roger225/DapLink_STM32F103CBT6/DapLink_STM32F103CBT6.step

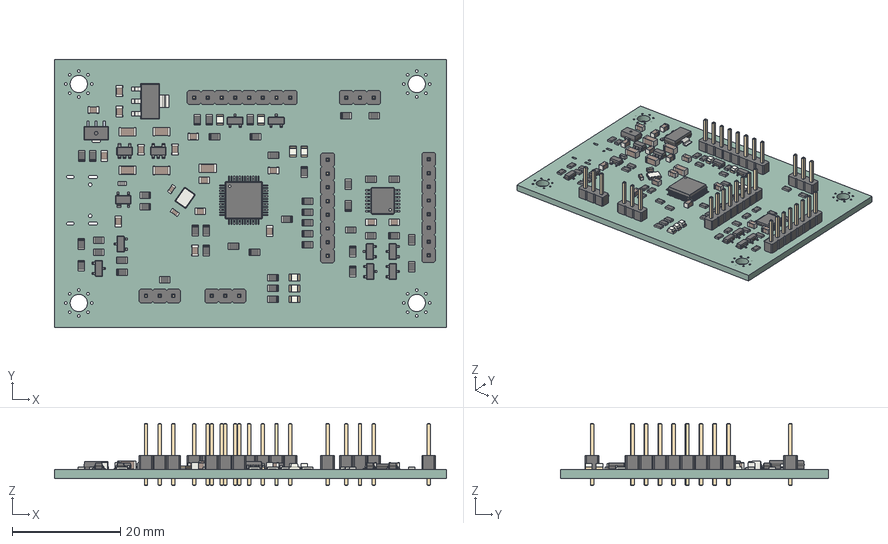
[picture p1: CAD file, 2024-07-27]
DapLink_STM32F103CBT6.step
72.5 x 49.5 x 11.5 mm
R_0805_2012Metric x 45
PinHeader_1x08_P254mm_Vertical x 3
C_0805_2012Metric x 15
TSSOP_14_44x5mm_P065mm
SOT_23_5 x 2
C_1206_3216Metric x 5
PinHeader_1x03_P254mm_Vertical x 3
LED_0805_2012Metric x 7
SOT_23 x 8
CQ assembly
SOT_143
C_0603_1608Metric x 2
L_0603_1608Metric
Crystal_SMD_3225-4Pin_3.2x2.5mm
LQFP_48_7x7mm_P05mm
SOT_223
DapLink_STM32F103CBT6_PCB
