roger225/DapLink_STM32F103CBT6/RefDesign/Interface Schematics/DAPlink_STM32F103-v1.0.0_20200618.pdf

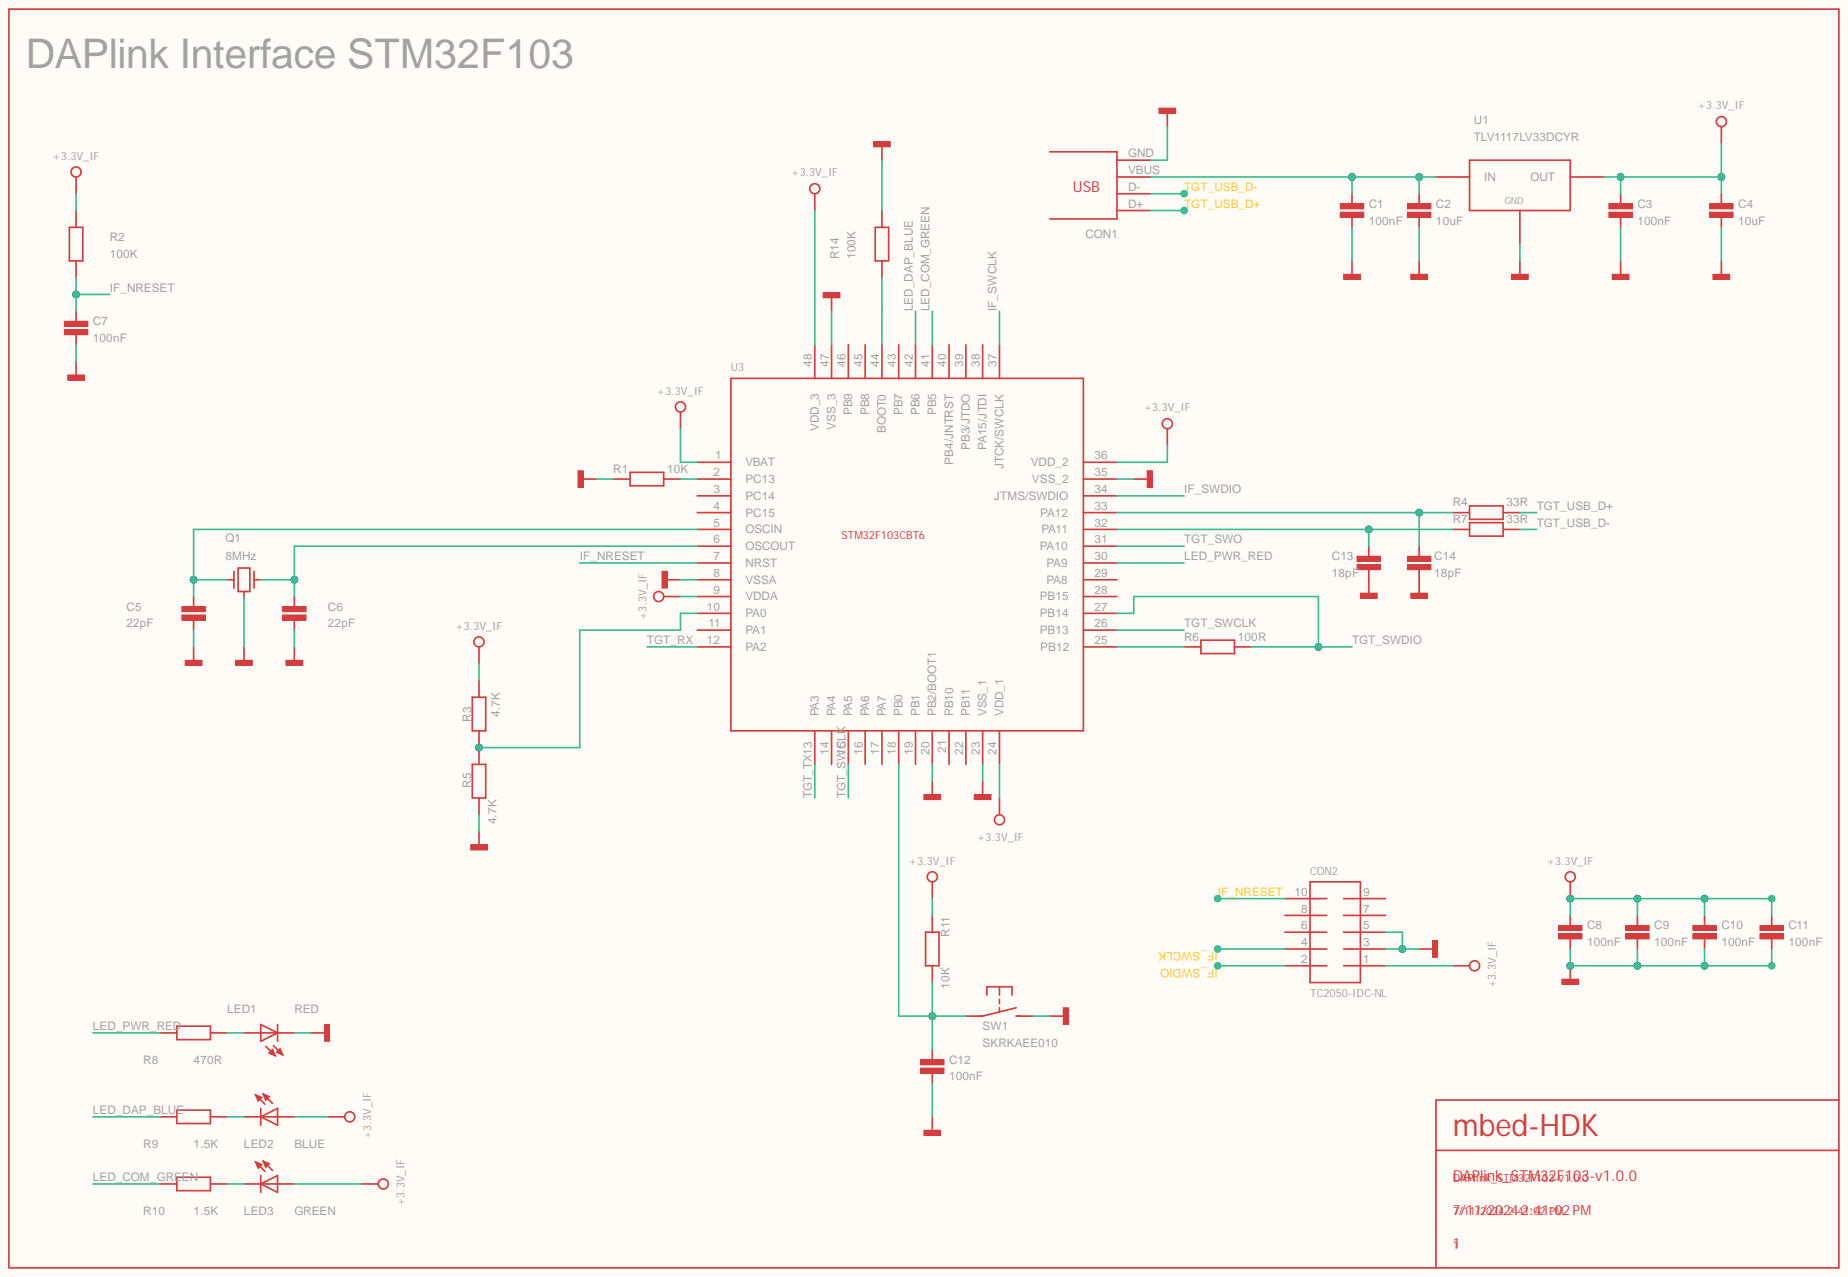
[picture p3: page 1]
