roger225/DapLink_STM32F103CBT6/DapLink_STM32F103CBT6.kicad_pcb

## KiCad design DapLink_STM32F103CBT6.kicad_pcb (2024-08-18)

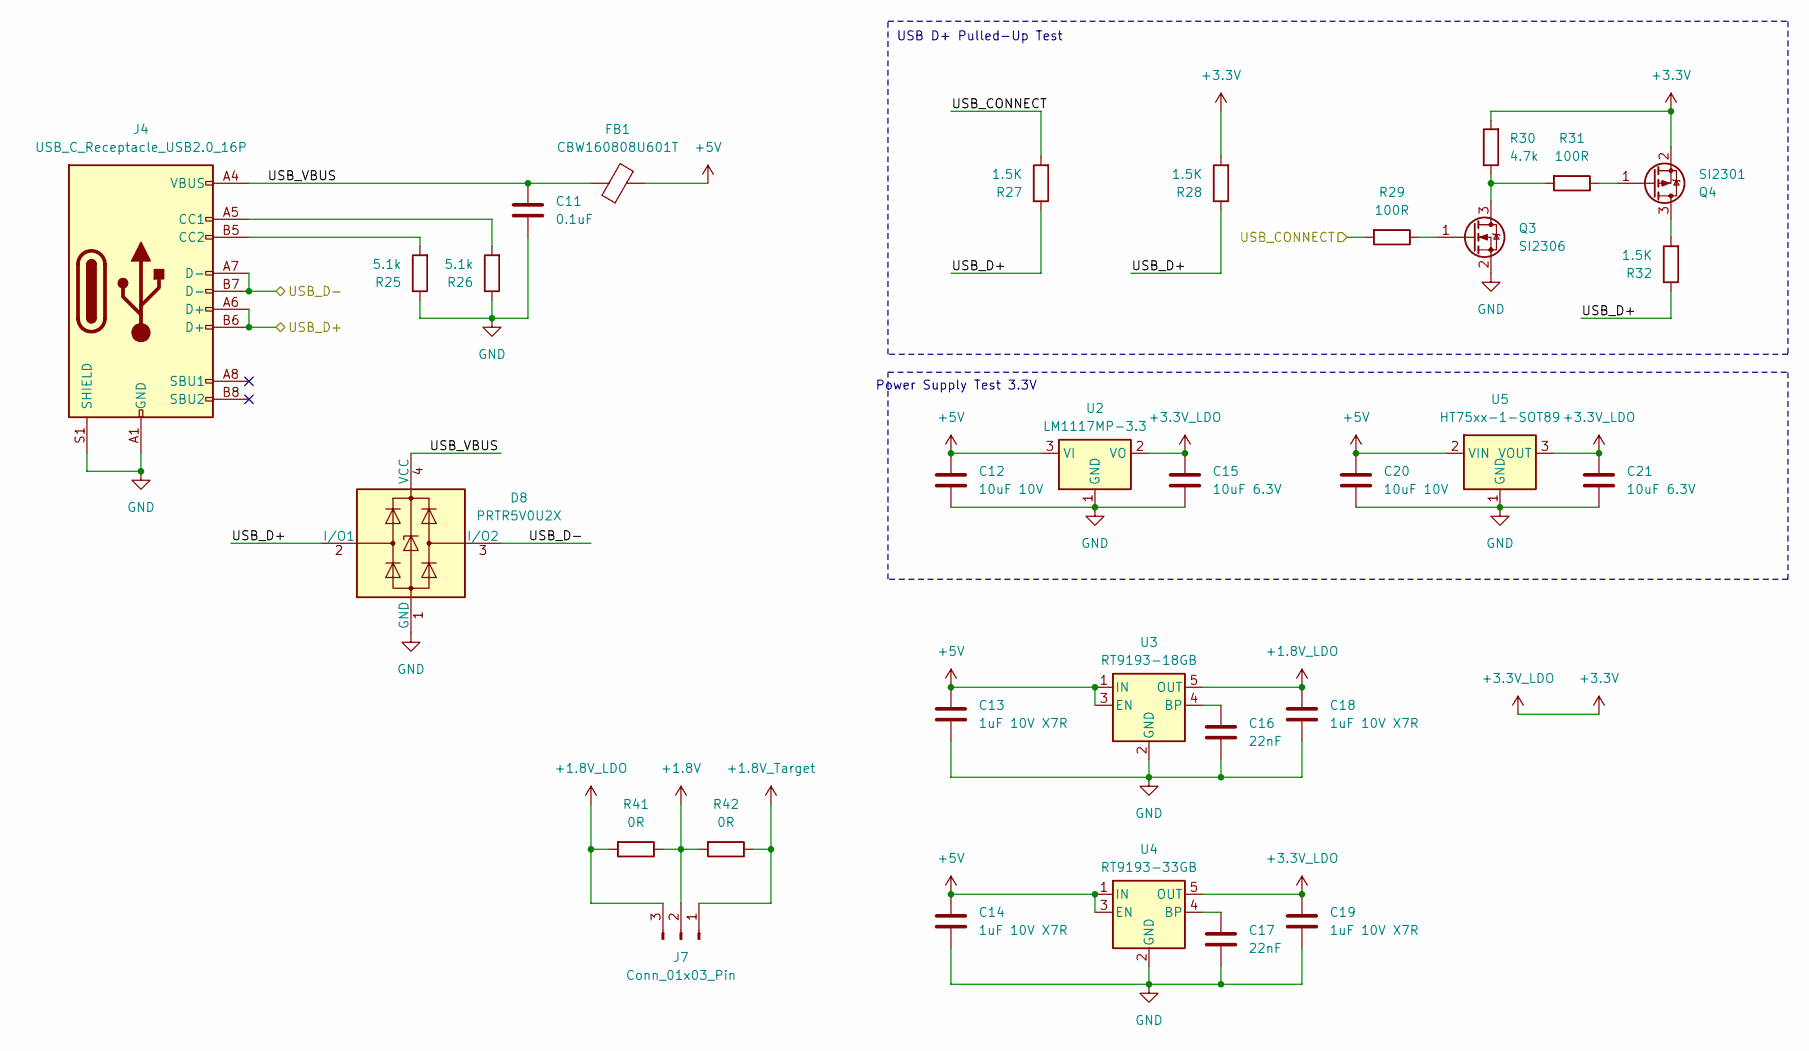
[picture p4: schematic UsbAndPower.kicad_sch, DapLink_STM32F103CBT6]

Parts:
C11: 0.1uF; C_0805_2012Metric
C12, C20: 10uF 10V; C_0805_2012Metric
C13, C14, C18, C19: 1uF 10V X7R; C_1206_3216Metric
C15, C21: 10uF 6.3V; C_0805_2012Metric
C16, C17: 22nF; C_0805_2012Metric
D8: PRTR5V0U2X; SOT-143
FB1: CBW160808U601T; L_0603_1608Metric
J4: USB_C_Receptacle_USB2.0_16P; USB_C_Receptacle_G-Switch_GT-USB-7010ASV
J7: Conn_01x03_Pin; PinHeader_1x03_P2.54mm_Vertical
Q3: SI2306; SOT-23
Q4: SI2301; SOT-23
R25, R26: 5.1k; R_0805_2012Metric
R27, R28, R32: 1.5K; R_0805_2012Metric
R29, R31: 100R; R_0805_2012Metric
R30: 4.7k; R_0805_2012Metric
R41, R42: 0R; R_0805_2012Metric
U2: LM1117MP-3.3; SOT-223-3_TabPin2
U3: RT9193-18GB; SOT-23-5
U4: RT9193-33GB; SOT-23-5
U5: HT75xx-1-SOT89; SOT-89-3

Connections:
+1.8V: J7.2, R41.1, R42.2; also elsewhere on the board
+1.8V_LDO: C18.1, J7.3, R41.2, U3.5 (OUT)
+1.8V_Target: J7.1, R42.1; also elsewhere on the board
+3.3V: C15.1, C19.1, C21.1, Q4.2 (S), R28.2, R30.2, U2.2 (VO), U4.5 (OUT), U5.3 (VOUT); also elsewhere on the board
+5V: C12.1, C13.1, C14.1, C20.1, FB1.2, U2.3 (VI), U3.1 (IN), U3.3 (EN), U4.1 (IN), U4.3 (EN), U5.2 (VIN)
/UsbAndPower/USB_CONNECT: R27.2, R29.2; also elsewhere on the board
/UsbAndPower/USB_D+: D8.2 (I/O1), J4.A6 (D+), J4.B6 (D+), R27.1, R28.1, R32.1; also elsewhere on the board
/UsbAndPower/USB_D-: D8.3 (I/O2), J4.A7 (D-), J4.B7 (D-); also elsewhere on the board
/UsbAndPower/USB_VBUS: C11.1, D8.4 (VCC), FB1.1, J4.A4 (VBUS), J4.A9 (VBUS), J4.B4 (VBUS), J4.B9 (VBUS)
GND: C11.2, C12.2, C13.2, C14.2, C15.2, C16.2, C17.2, C18.2, C19.2, C20.2, C21.2, D8.1 (GND), J4.A1 (GND), J4.A12 (GND), J4.B1 (GND), J4.B12 (GND), J4.S1 (SHIELD), Q3.2 (S), R25.1, R26.1, U2.1 (GND), U3.2 (GND), U4.2 (GND), U5.1 (GND); also elsewhere on the board
unnamed: J4.A5 (CC1), R26.2
unnamed: J4.B5 (CC2), R25.2
unnamed: Q3.3 (D), R30.1, R31.2
unnamed: Q3.1 (G), R29.1
unnamed: Q4.3 (D), R32.2
unnamed: Q4.1 (G), R31.1
unnamed: C16.1, U3.4 (BP)
unnamed: C17.1, U4.4 (BP)

Notes on the sheet:
Power Supply Test 3.3V
USB D+ Pulled-Up Test

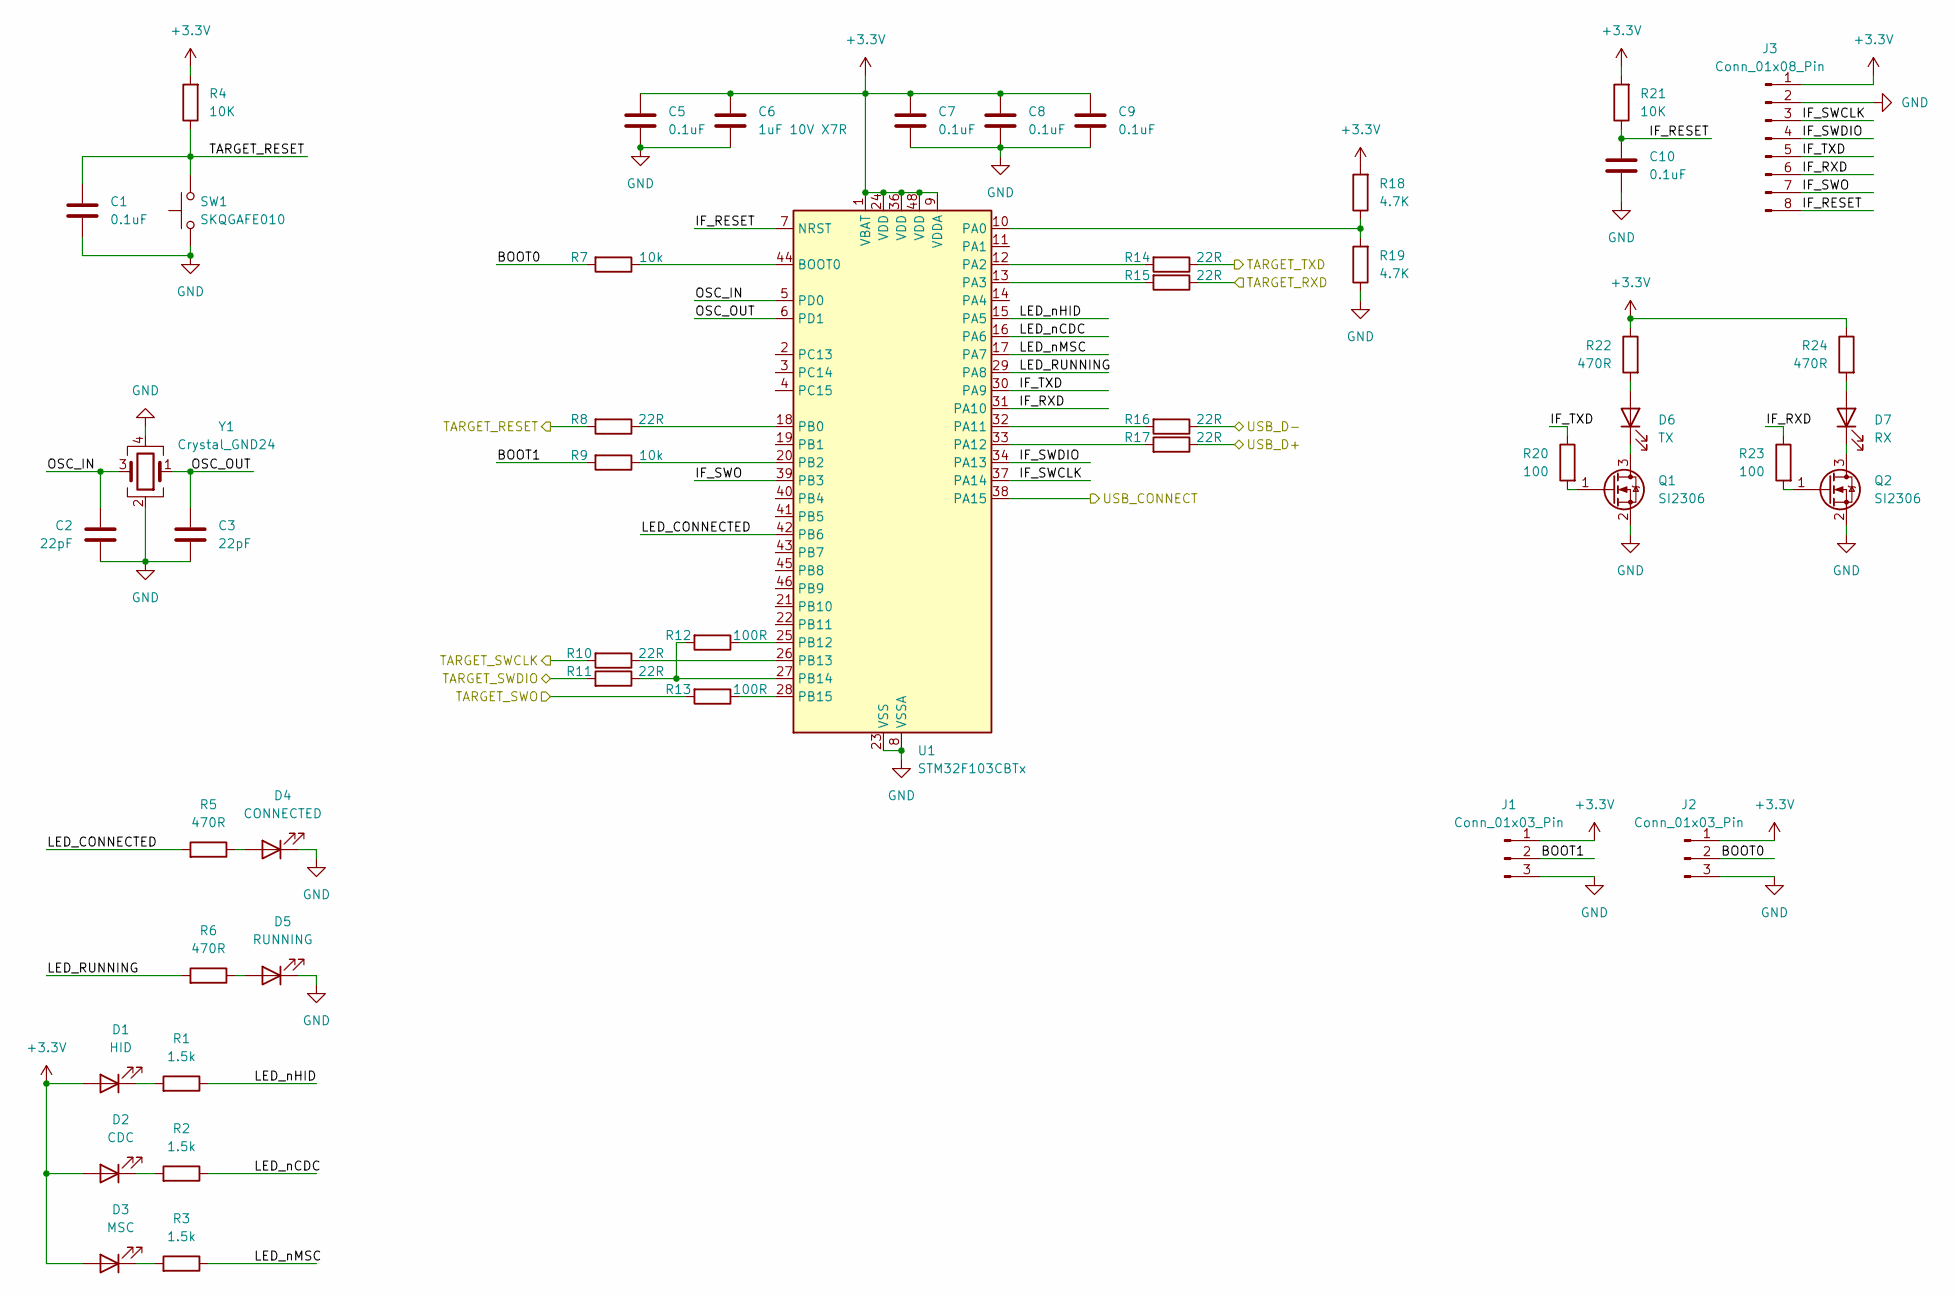
[picture p5: schematic Mcu.kicad_sch, DapLink_STM32F103CBT6]

Parts:
C1, C5, C7, C8, C9, C10: 0.1uF; C_0805_2012Metric
C2, C3: 22pF; C_0603_1608Metric
C6: 1uF 10V X7R; C_1206_3216Metric
D1: HID; LED_0805_2012Metric
D2: CDC; LED_0805_2012Metric
D3: MSC; LED_0805_2012Metric
D4: CONNECTED; LED_0805_2012Metric
D5: RUNNING; LED_0805_2012Metric
D6: TX; LED_0805_2012Metric
D7: RX; LED_0805_2012Metric
J1, J2: Conn_01x03_Pin; PinHeader_1x03_P2.54mm_Vertical
J3: Conn_01x08_Pin; PinHeader_1x08_P2.54mm_Vertical
Q1, Q2: SI2306; SOT-23
R1, R2, R3: 1.5k; R_0805_2012Metric
R4, R21: 10K; R_0805_2012Metric
R5, R6, R22, R24: 470R; R_0805_2012Metric
R7, R9: 10k; R_0805_2012Metric
R8, R10, R11, R14, R15, R16, R17: 22R; R_0805_2012Metric
R12, R13: 100R; R_0805_2012Metric
R18, R19: 4.7K; R_0805_2012Metric
R20, R23: 100; R_0805_2012Metric
SW1: SKQGAFE010; SW_SPST_SKQG_WithStem
U1: STM32F103CBTx; LQFP-48_7x7mm_P0.5mm
Y1: Crystal_GND24; Crystal_SMD_3225-4Pin_3.2x2.5mm

Connections:
+3.3V: C5.1, C6.1, C7.1, C8.1, C9.1, D1.2 (A), D2.2 (A), D3.2 (A), J1.1, J2.1, J3.1, R4.2, R18.2, R21.2, R22.1, R24.1, U1.1 (VBAT), U1.9 (VDDA), U1.24 (VDD), U1.36 (VDD), U1.48 (VDD); also elsewhere on the board
/DebugAndUart/TARGET_RESET: C1.1, R4.1, R8.2, SW1.2; also elsewhere on the board
/DebugAndUart/TARGET_RXD: R15.1; also elsewhere on the board
/DebugAndUart/TARGET_SWCLK: R10.2; also elsewhere on the board
/DebugAndUart/TARGET_SWDIO: R11.2; also elsewhere on the board
/DebugAndUart/TARGET_SWO: R13.2; also elsewhere on the board
/DebugAndUart/TARGET_TXD: R14.1; also elsewhere on the board
/Mcu/BOOT0: J2.2, R7.2
/Mcu/BOOT1: J1.2, R9.2
/Mcu/IF_RESET: C10.1, J3.8, R21.1, U1.7 (NRST)
/Mcu/IF_RXD: J3.6, R23.1, U1.31 (PA10)
/Mcu/IF_SWCLK: J3.3, U1.37 (PA14)
/Mcu/IF_SWDIO: J3.4, U1.34 (PA13)
/Mcu/IF_SWO: J3.7, U1.39 (PB3)
/Mcu/IF_TXD: J3.5, R20.1, U1.30 (PA9)
/Mcu/LED_CONNECTED: R5.2, U1.42 (PB6)
/Mcu/LED_RUNNING: R6.2, U1.29 (PA8)
/Mcu/LED_nCDC: R2.1, U1.16 (PA6)
/Mcu/LED_nHID: R1.1, U1.15 (PA5)
/Mcu/LED_nMSC: R3.1, U1.17 (PA7)
/Mcu/OSC_IN: C2.2, U1.5 (PD0), Y1.3
/Mcu/OSC_OUT: C3.1, U1.6 (PD1), Y1.1
/UsbAndPower/USB_CONNECT: U1.38 (PA15); also elsewhere on the board
/UsbAndPower/USB_D+: R17.1; also elsewhere on the board
/UsbAndPower/USB_D-: R16.1; also elsewhere on the board
GND: C1.2, C2.1, C3.2, C5.2, C6.2, C7.2, C8.2, C9.2, C10.2, D4.1 (K), D5.1 (K), J1.3, J2.3, J3.2, Q1.2 (S), Q2.2 (S), R19.1, SW1.1, U1.8 (VSSA), U1.23 (VSS), U1.35 (VSS), U1.47 (VSS), Y1.2, Y1.4; also elsewhere on the board
unnamed: D1.1 (K), R1.2
unnamed: D2.1 (K), R2.2
unnamed: D3.1 (K), R3.2
unnamed: D4.2 (A), R5.1
unnamed: D5.2 (A), R6.1
unnamed: D6.2 (A), R22.2
unnamed: D6.1 (K), Q1.3 (D)
unnamed: D7.2 (A), R24.2
unnamed: D7.1 (K), Q2.3 (D)
unnamed: Q1.1 (G), R20.2
unnamed: Q2.1 (G), R23.2
unnamed: R7.1, U1.44 (BOOT0)
unnamed: R18.1, R19.2, U1.10 (PA0)
unnamed: R14.2, U1.12 (PA2)
unnamed: R15.2, U1.13 (PA3)
unnamed: R16.2, U1.32 (PA11)
unnamed: R17.2, U1.33 (PA12)
unnamed: R8.1, U1.18 (PB0)
unnamed: R9.1, U1.20 (PB2)
unnamed: R12.1, U1.25 (PB12)
unnamed: R10.1, U1.26 (PB13)
unnamed: R11.1, R12.2, U1.27 (PB14)
unnamed: R13.1, U1.28 (PB15)

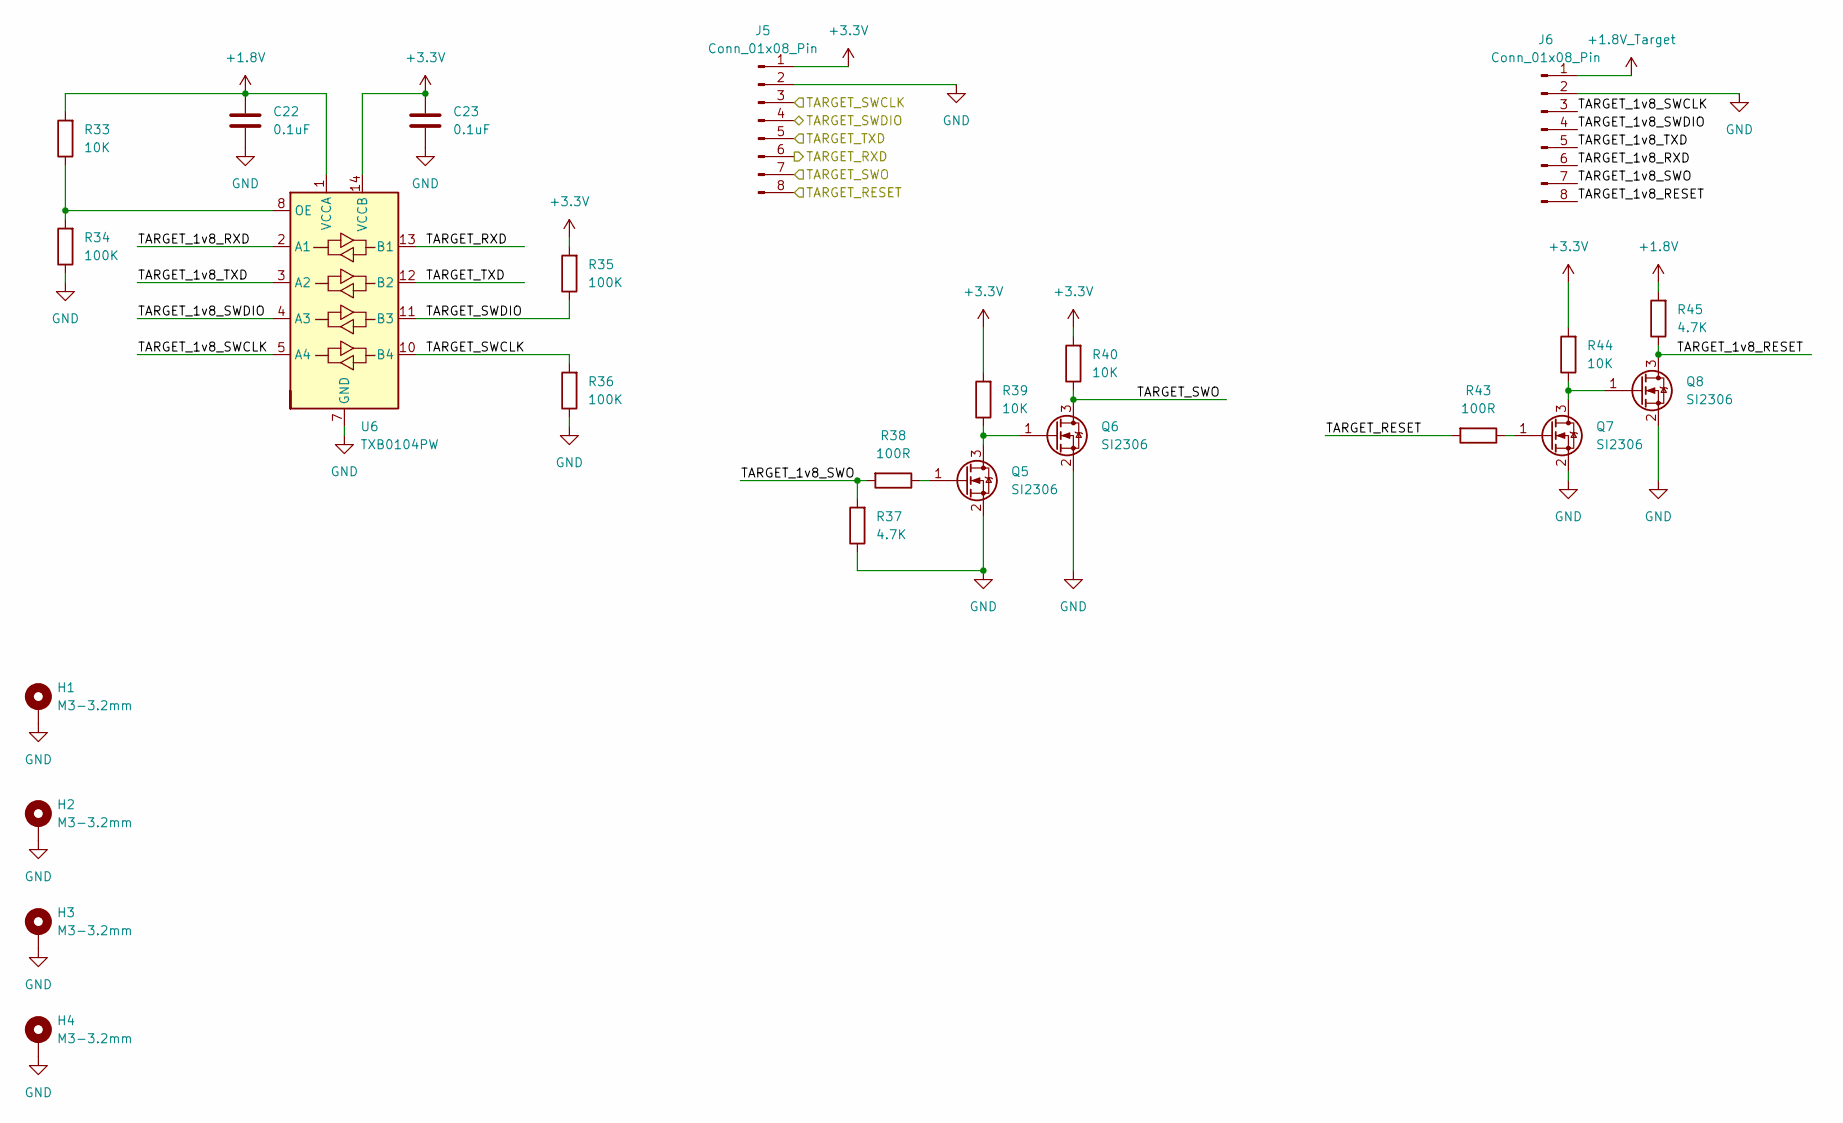
[picture p6: schematic DebugAndUart.kicad_sch, DapLink_STM32F103CBT6]

Parts:
C22, C23: 0.1uF; C_0805_2012Metric
H1, H2, H3, H4: M3-3.2mm; MountingHole_3.2mm_M3_Pad_Via
J5, J6: Conn_01x08_Pin; PinHeader_1x08_P2.54mm_Vertical
Q5, Q6, Q7, Q8: SI2306; SOT-23
R33, R39, R40, R44: 10K; R_0805_2012Metric
R34, R35, R36: 100K; R_0805_2012Metric
R37, R45: 4.7K; R_0805_2012Metric
R38, R43: 100R; R_0805_2012Metric
U6: TXB0104PW; TSSOP-14_4.4x5mm_P0.65mm

Connections:
+1.8V: C22.1, R33.2, R45.2, U6.1 (VCCA); also elsewhere on the board
+1.8V_Target: J6.1; also elsewhere on the board
+3.3V: C23.1, J5.1, R35.2, R39.2, R40.2, R44.2, U6.14 (VCCB); also elsewhere on the board
/DebugAndUart/TARGET_1v8_RESET: J6.8, Q8.3 (D), R45.1
/DebugAndUart/TARGET_1v8_RXD: J6.6, U6.2 (A1)
/DebugAndUart/TARGET_1v8_SWCLK: J6.3, U6.5 (A4)
/DebugAndUart/TARGET_1v8_SWDIO: J6.4, U6.4 (A3)
/DebugAndUart/TARGET_1v8_SWO: J6.7, R37.2, R38.2
/DebugAndUart/TARGET_1v8_TXD: J6.5, U6.3 (A2)
/DebugAndUart/TARGET_RESET: J5.8, R43.2; also elsewhere on the board
/DebugAndUart/TARGET_RXD: J5.6, U6.13 (B1); also elsewhere on the board
/DebugAndUart/TARGET_SWCLK: J5.3, R36.2, U6.10 (B4); also elsewhere on the board
/DebugAndUart/TARGET_SWDIO: J5.4, R35.1, U6.11 (B3); also elsewhere on the board
/DebugAndUart/TARGET_SWO: J5.7, Q6.3 (D), R40.1; also elsewhere on the board
/DebugAndUart/TARGET_TXD: J5.5, U6.12 (B2); also elsewhere on the board
GND: C22.2, C23.2, H1.1, H2.1, H3.1, H4.1, J5.2, J6.2, Q5.2 (S), Q6.2 (S), Q7.2 (S), Q8.2 (S), R34.1, R36.1, R37.1, U6.7 (GND); also elsewhere on the board
unnamed: Q5.3 (D), Q6.1 (G), R39.1
unnamed: Q5.1 (G), R38.1
unnamed: Q7.3 (D), Q8.1 (G), R44.1
unnamed: Q7.1 (G), R43.1
unnamed: R33.1, R34.2, U6.8 (OE)

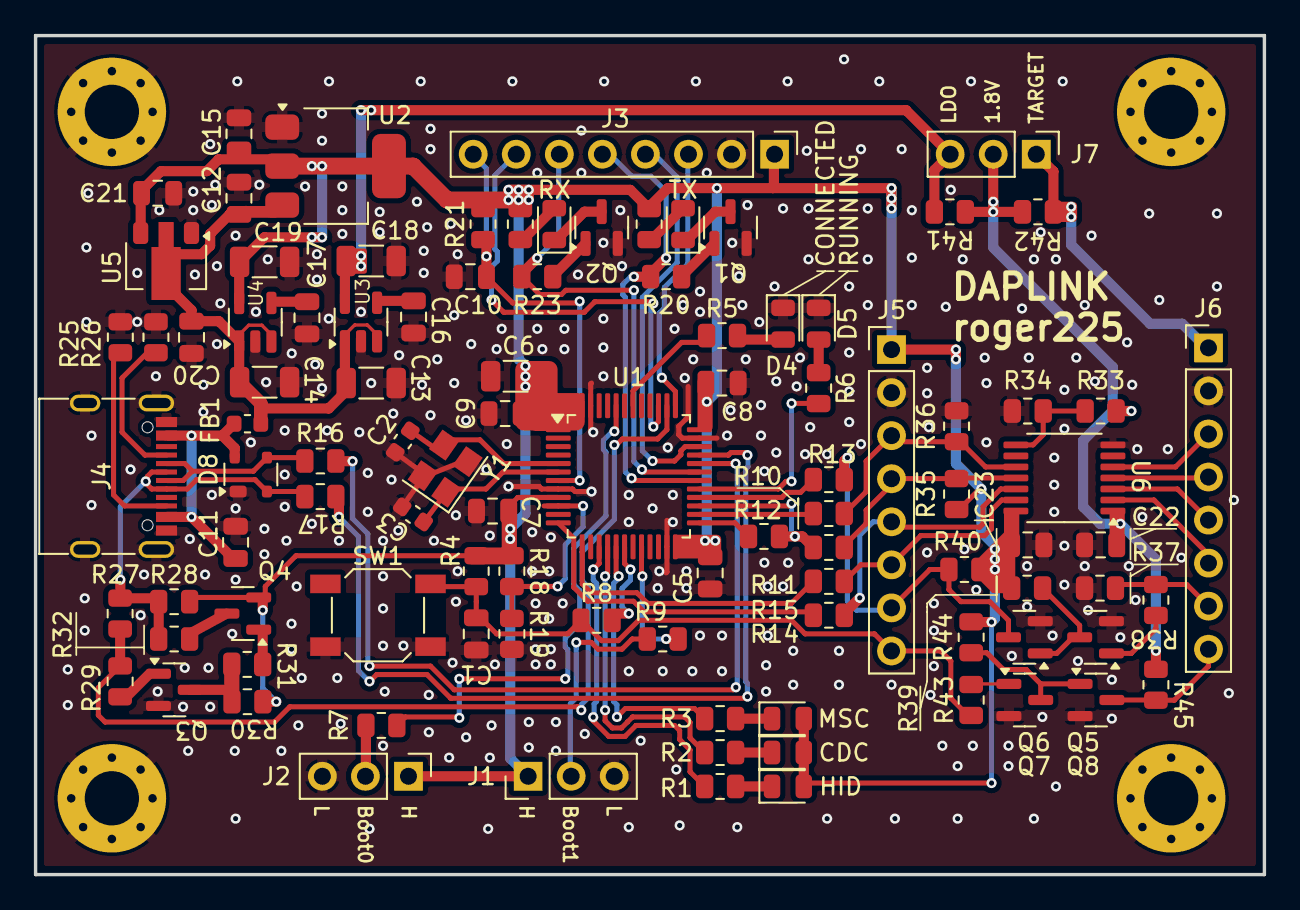
[picture p7: board DapLink_STM32F103CBT6.kicad_pcb from above]

Board: 2 copper layers, 72.5 x 49.5 mm, 103 parts (0 on the bottom side), 73 nets.
