roger225/DapLink_STM32F103CBT6/(commit log)

2024-07-27 fabrication v1
    [DapLink_STM32F103CBT6-B_Cu.gbr, DapLink_STM32F103CBT6-B_Mask.gbr, DapLink_STM32F103CBT6-B_Paste.gbr, DapLink_STM32F103CBT6-B_Silkscreen.gbr, DapLink_STM32F103CBT6-Edge_Cuts.gbr, DapLink_STM32F103CBT6-F_Cu.gbr, DapLink_STM32F103CBT6-F_Mask.gbr, DapLink_STM32F103CBT6-F_Paste.gbr]
2024-08-18 modify F.SilkS for C20 and R26
    [DapLink_STM32F103CBT6-B_Cu.gbr, DapLink_STM32F103CBT6-B_Mask.gbr, DapLink_STM32F103CBT6-B_Paste.gbr, DapLink_STM32F103CBT6-B_Silkscreen.gbr, DapLink_STM32F103CBT6-Edge_Cuts.gbr, DapLink_STM32F103CBT6-F_Cu.gbr, DapLink_STM32F103CBT6-F_Mask.gbr, DapLink_STM32F103CBT6-F_Paste.gbr]
